plorefice/chip8-rs/chip8-pcb/models/2_42inch_oled_module-sku25742_asm.stp

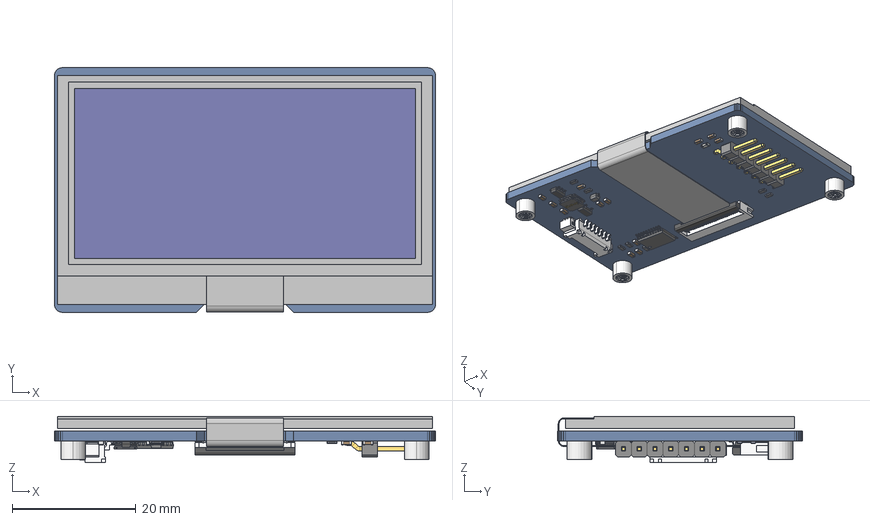
[picture p1: CAD file, 2024-06-08]
chip8-pcb/models/2_42inch_oled_module-sku25742_asm.stp
61.5 x 39.5 x 7.50 mm
BOARD
CAPC1608_0603_ x 12
USER_LIBRARY-1N4148WS
RESC1608_0603_ x 7
USER_LIBRARY-INDLQS_4012_-11547
USER_LIBRARY-INDLQS_4012_-22184 x 2
USER_LIBRARY-INDLQS_4012_-22696
HEADER-FPC-ZIF-SMD-HORIZO-23832
HEADER-FPC-ZIF-SMD-HORIZO-85751
EXTRUDED-87228
EXTRUDED-87600 x 2
SW3DPS-SOT-23-5-DEFAULT x 2
USER_LIBRARY-TSSOP-20-2__-93530
USER_LIBRARY-TSSOP-20-2__-94481
USER_LIBRARY-TSSOP-20-2__-946_1 x 10
USER_LIBRARY-TSSOP-20-2__-946_2 x 10
HDR2_54_S-W-1P-96724 x 7
LOGO0_25_10 x 7
LOGO0_25_20 x 7
LOGO0_25_30 x 7
LOGO0_25_40 x 7
LOGO0_25_50 x 7
LOGO0_25_60 x 7
LOGO0_25_70 x 7
LOGO0_25_80 x 7
LOGO0_25_90 x 7
LOGO0_25_100 x 7
LOGO0_25_110 x 7
LOGO0_25_120 x 7
LOGO0_25_130 x 7
LOGO0_25_140 x 7
2_42INCH-128X64-QLED
HP1_25MM-1X7PIN-SMT
SMTSO-M2_5-4-3ET x 4
