plorefice/chip8-rs/chip8-case/Litio_523450.FCStd

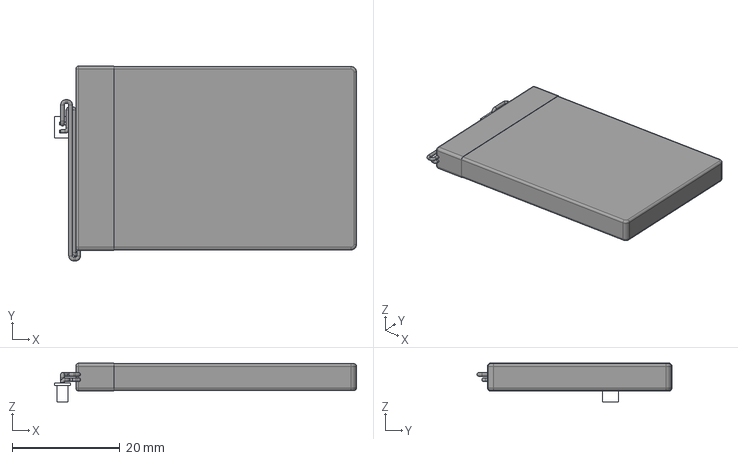
[picture p2: CAD file, 2024-06-12]
chip8-case/Litio_523450.FCStd
56.0 x 36.2 x 7.20 mm
Conector
