plorefice/chip8-rs/chip8-pcb/chip8-pcb.step

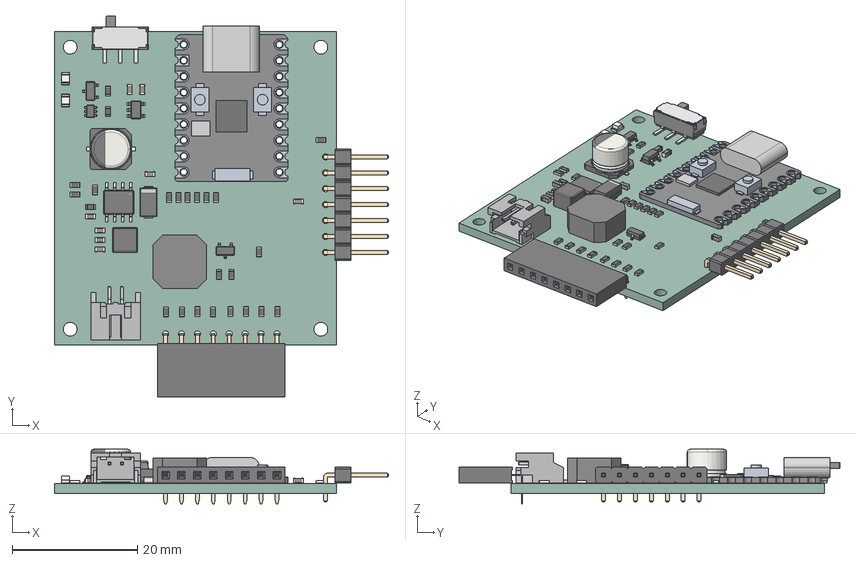
[picture p3: CAD file, 2024-06-12]
chip8-pcb/chip8-pcb.step
53.3 x 60.7 x 8.70 mm
R_0603_1608Metric x 23
SOT_23_5
C_0603_1608Metric x 8
S2B-PH-SM4-TB v1
HTSOP_8_1EP_39x49mm_P127mm_EP24x32mm
CQ assembly
LED_0805_2012Metric x 2
SOT_363_SC_70_6
PinHeader_1x07_P254mm_Horizontal
SOT_23 x 2
CP_Elec_63x54
Fuse_0603_1608Metric
JS102011SAQN
ESP32-C3 Zero (Waveshare) v6
PinSocket_1x08_P254mm_Horizontal
D_SMA
chip8-pcb_PCB
