plorefice/chip8-rs/chip8-pcb/models/JST-PH-2.step

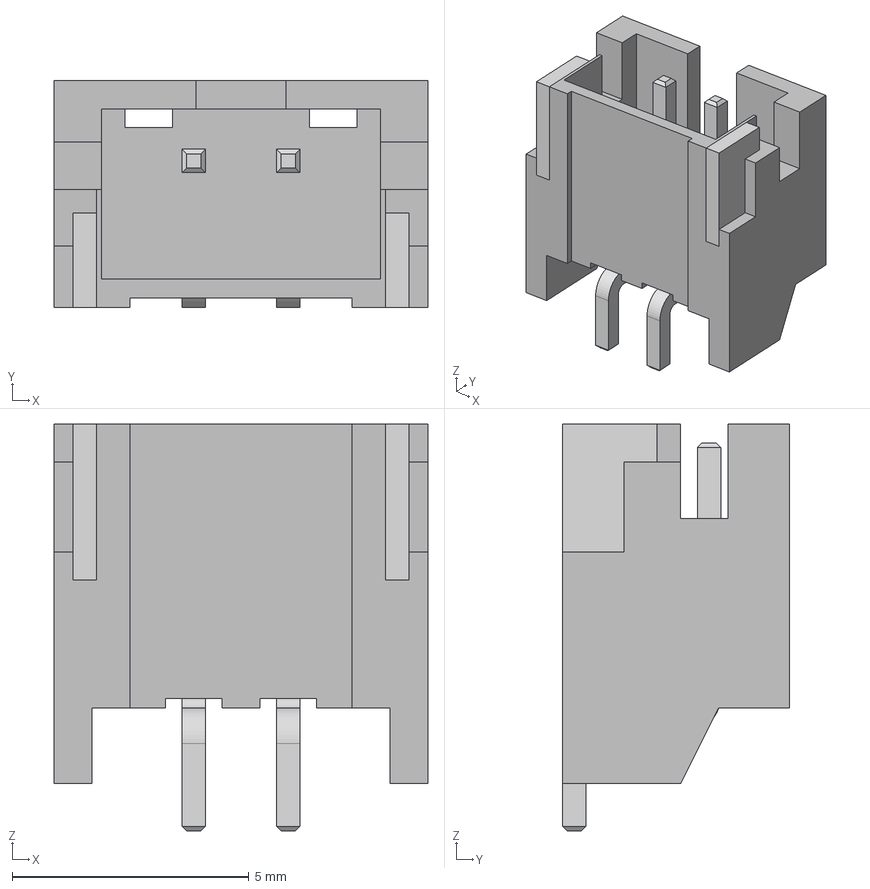
[picture p4: CAD file, 2024-06-08]
chip8-pcb/models/JST-PH-2.step
7.90 x 4.80 x 8.60 mm
