plorefice/chip8-rs/chip8-case/CHIP-8.FCStd

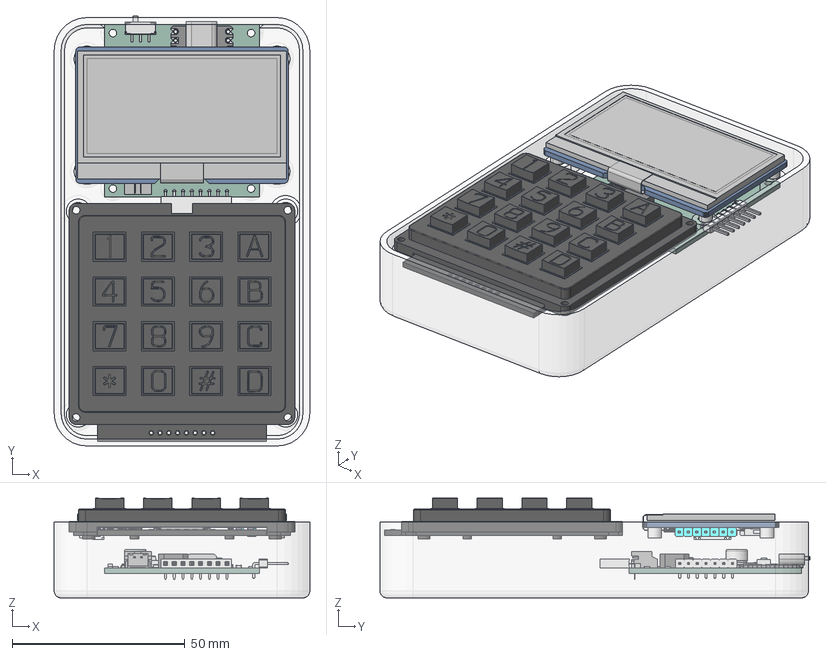
[picture p5: CAD file, 2024-06-12]
chip8-case/CHIP-8.FCStd
74.0 x 124.4 x 28.9 mm
BackCase
R_0603_1608Metric
SOT_23_5
C_0603_1608Metric
R_0603_1608Metric002
C_0603_1608Metric002
S2B-PH-SM4-TB v1
S2B-PH-SM4-TB v002
S2B-PH-SM4-TB v003
S2B-PH-SM4-TB v004
S2B-PH-SM4-TB v005
R_0603_1608Metric004
R_0603_1608Metric006
C_0603_1608Metric004
R_0603_1608Metric008
C_0603_1608Metric006
HTSOP_8_1EP_39x49mm_P127mm_EP24x32mm
CQ assembly
CQ assembly001
CQ assembly002
R_0603_1608Metric010
R_0603_1608Metric012
R_0603_1608Metric014
C_0603_1608Metric008
R_0603_1608Metric016
R_0603_1608Metric018
R_0603_1608Metric020
R_0603_1608Metric022
LED_0805_2012Metric
C_0603_1608Metric010
SOT_363_SC_70_6
PinHeader_1x07_P254mm_Horizontal
R_0603_1608Metric024
SOT_23
C_0603_1608Metric012
R_0603_1608Metric026
SOT_024
CP_Elec_63x54
R_0603_1608Metric028
LED_0805_2012Metric002
Fuse_0603_1608Metric
R_0603_1608Metric030
R_0603_1608Metric032
R_0603_1608Metric034
C_0603_1608Metric014
R_0603_1608Metric036
JS102011SAQN
R_0603_1608Metric038
ESP32-C3 Zero (Waveshare) v6
ESP32-C3 Zero (Waveshare) v007
ESP32-C3 Zero (Waveshare) v008
ESP32-C3 Zero (Waveshare) v009
ESP32-C3 Zero (Waveshare) v010
ESP32-C3 Zero (Waveshare) v011
ESP32-C3 Zero (Waveshare) v012
ESP32-C3 Zero (Waveshare) v013
ESP32-C3 Zero (Waveshare) v014
ESP32-C3 Zero (Waveshare) v015
ESP32-C3 Zero (Waveshare) v016
ESP32-C3 Zero (Waveshare) v017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
