plorefice/chip8-rs/chip8-pcb/models/Waveshare ESP32-C3 Zero.step

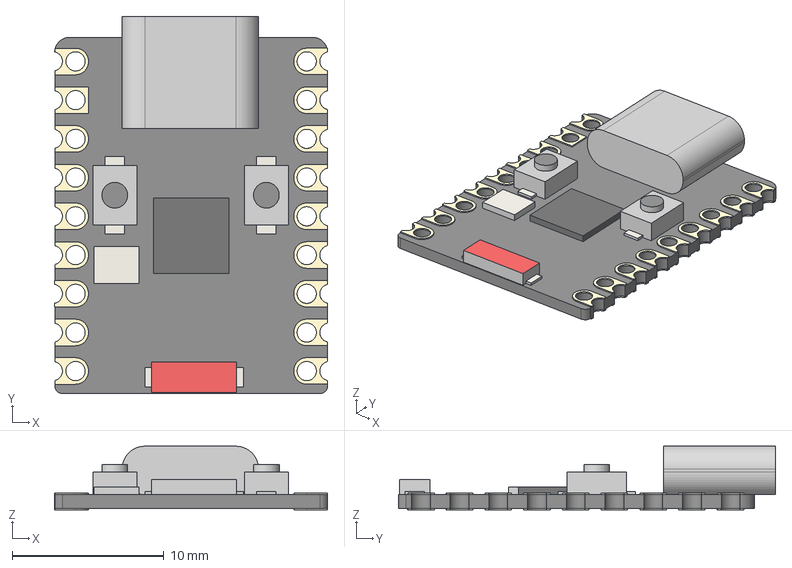
[picture p6: CAD file, 2024-06-08]
chip8-pcb/models/Waveshare ESP32-C3 Zero.step
18.0 x 24.9 x 4.20 mm
PCB
USB Type-C
SoC
BOOT
RESET
Crystal
Antenna
