plorefice/chip8-rs/chip8-pcb/models/mlt-8540.step

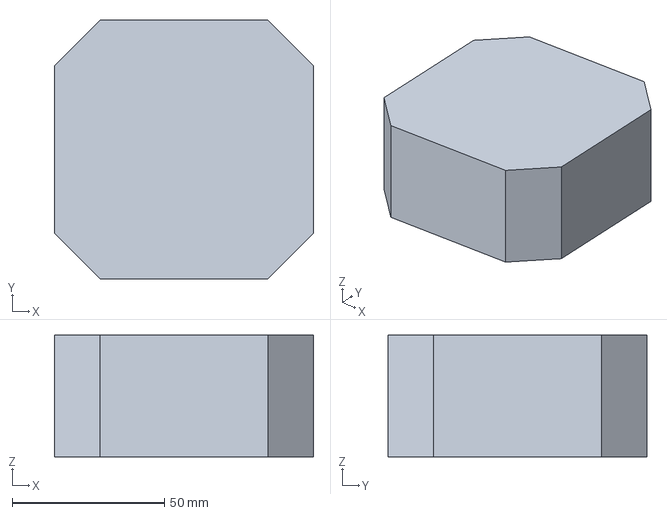
[picture p7: CAD file, 2024-06-08]
chip8-pcb/models/mlt-8540.step
85.0 x 85.0 x 40.0 mm
