plorefice/chip8-rs/chip8-pcb/models/JS102011SAQN.STEP

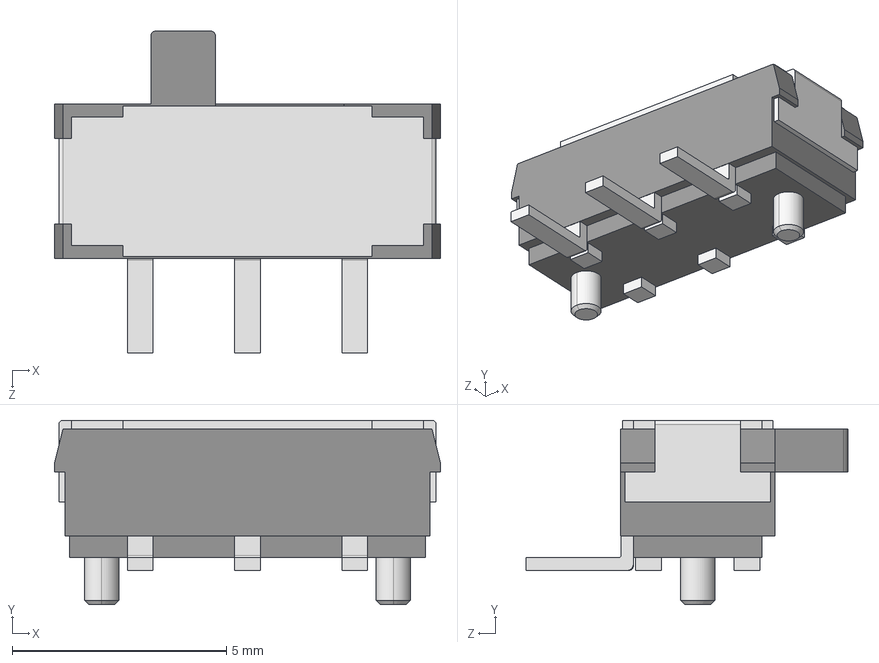
[picture p8: CAD file, 2024-06-08]
chip8-pcb/models/JS102011SAQN.STEP
9.00 x 4.30 x 7.50 mm
