plorefice/chip8-rs/(list of files, cad)

Other CAD files:
chip8-pcb/models/mlt-8540.FCStd
