plorefice/chip8-rs/chip8-pcb/chip8-pcb.kicad_pcb

## KiCad design chip8-pcb/chip8-pcb.kicad_pcb (2024-06-12)

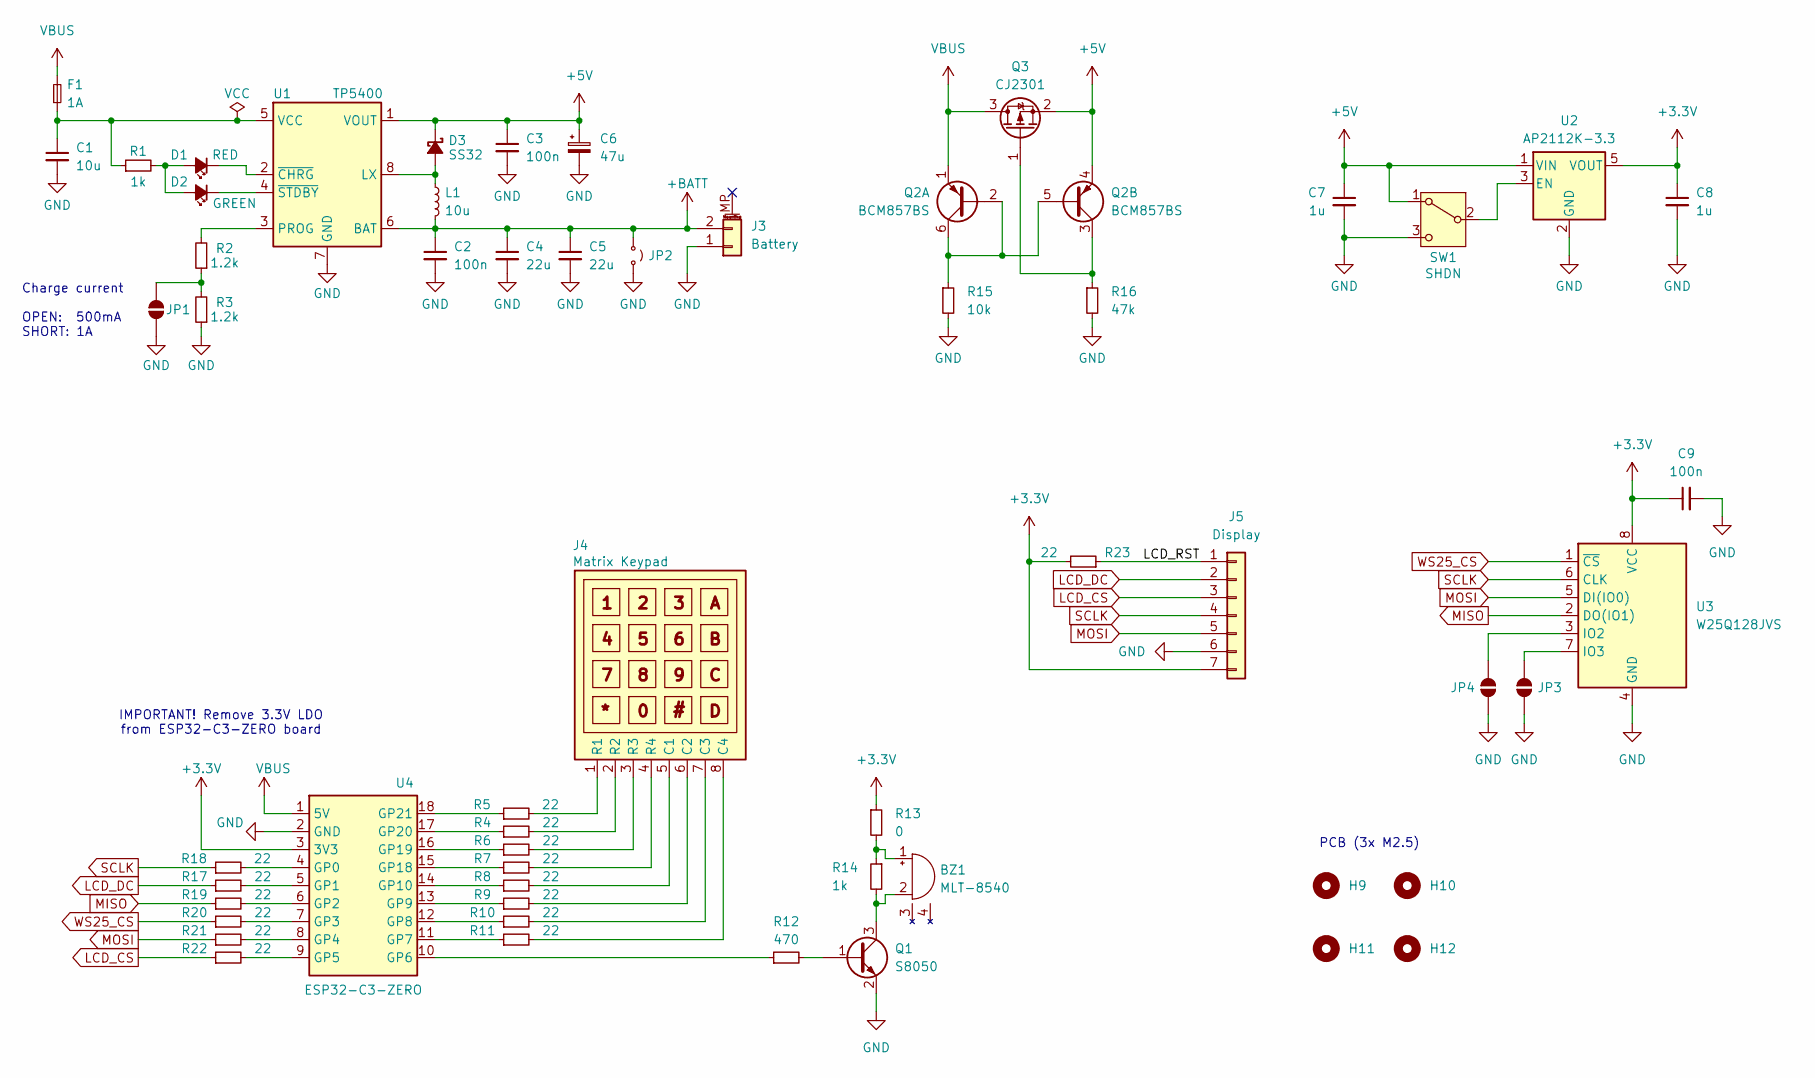
[picture p9: schematic chip8-pcb.kicad_sch, CHIP-8 Portable]

Parts:
BZ1: MLT-8540; LCSC Part Number C95300
C1: 10u; C_0603_1608Metric; LCSC Part Number C96446
C2, C3, C9: 100n; C_0603_1608Metric; LCSC Part Number C14663
C4, C5: 22u; C_0603_1608Metric; LCSC Part Number C59461
C6: 47u; CP_Elec_6.3x5.4; LCSC Part Number C72521
C7, C8: 1u; C_0603_1608Metric; LCSC Part Number C15849
D1: RED; LED_0805_2012Metric; LCSC Part Number C84256
D2: GREEN; LED_0805_2012Metric; LCSC Part Number C2297
D3: SS32; D_SMA; LCSC Part Number C34897
F1: 1A; Fuse_0603_1608Metric; LCSC Part Number C151139
H9, H10, H11, H12: MountingHole_2.2mm_M2
J3: Battery; BOOMELE_PH-2P_1x2P_P2.00mm_Horizontal; LCSC Part Number C47647
J4: Matrix Keypad; PinSocket_1x08_P2.54mm_Horizontal
J5: Display; PinHeader_1x07_P2.54mm_Horizontal
JP1, JP2, JP3, JP4: SolderJumper-2_P1.3mm_Open_RoundedPad1.0x1.5mm
L1: 10u; L_Sunlord_SWPA4030S; LCSC Part Number C5363814
Q1: S8050; SOT-23; LCSC Part Number C2146
Q2: BCM857BS; SOT-363_SC-70-6; LCSC Part Number C105896
Q3: CJ2301; SOT-23; LCSC Part Number C8547
R1, R14: 1k; R_0603_1608Metric; LCSC Part Number C21190
R2, R3: 1.2k; R_0603_1608Metric; LCSC Part Number C22765
R4, R5, R6, R7, R8, R9, R10, R11, R17, R18, R19, R20, R21, R22, R23: 22; R_0603_1608Metric; LCSC Part Number C23345
R12: 470; R_0603_1608Metric; LCSC Part Number C23179
R13: 0; R_0603_1608Metric; LCSC Part Number C21189
R15: 10k; R_0603_1608Metric; LCSC Part Number C25804
R16: 47k; R_0603_1608Metric; LCSC Part Number C25819
SW1: SHDN; SW_SPDT_CK_JS102011SAQN; LCSC Part Number C221660
U1: TP5400; HTSOP-8-1EP_3.9x4.9mm_P1.27mm_EP2.4x3.2mm_ThermalVias; LCSC Part Number C2891434
U2: AP2112K-3.3; SOT-23-5; LCSC Part Number C51118
U3: W25Q128JVS; SOIC-8_5.23x5.23mm_P1.27mm; LCSC Part Number C97521
U4: ESP32-C3-ZERO; WaveShare_ESP32-C3-ZERO

Connections:
+3.3V: C8.1, C9.1, J5.7, R13.1, R23.2, U2.5 (VOUT), U3.8 (VCC), U4.3 (3V3)
+5V: C3.1, C6.1, C7.1, D3.1 (K), Q2.4 (E2), Q3.2 (S), SW1.1 (A), U1.1 (VOUT), U2.1 (VIN)
+BATT: C2.1, C4.1, C5.1, J3.2, JP2.1 (A), L1.2, U1.6 (BAT)
/LCD_RST: J5.1, R23.1
GND: C1.2, C2.2, C3.2, C4.2, C5.2, C6.2, C7.2, C8.2, C9.2, J3.1, J5.6, JP1.1 (A), JP2.2 (B), JP3.1 (A), JP4.1 (A), Q1.2 (E), R3.1, R15.2, R16.2, SW1.3 (C), U1.7 (GND), U1.9 (GND), U2.2 (GND), U3.4 (GND), U4.2 (GND)
LCD_CS: J5.3, R22.1
LCD_DC: J5.2, R17.1
MISO: R19.1, U3.2 (DO(IO1))
MOSI: J5.5, R21.1, U3.5 (DI(IO0))
unnamed: BZ1.1 (+), R13.2, R14.1
unnamed: BZ1.2 (-), Q1.3 (C), R14.2
unnamed: D1.2 (A), D2.2 (A), R1.2
unnamed: D1.1 (K), U1.2 (~CHRG)
unnamed: D2.1 (K), U1.4 (~STDBY)
unnamed: D3.2 (A), L1.1, U1.8 (LX)
unnamed: J4.6 (C2), R9.2
unnamed: J4.7 (C3), R10.2
unnamed: J4.8 (C4), R11.2
unnamed: J4.1 (R1), R5.2
unnamed: J4.2 (R2), R4.2
unnamed: J4.3 (R3), R6.2
unnamed: J4.4 (R4), R7.2
unnamed: J4.5 (C1), R8.2
unnamed: JP1.2 (B), R2.1, R3.2
unnamed: JP3.2 (B), U3.7 (IO3)
unnamed: JP4.2 (B), U3.3 (IO2)
unnamed: Q1.1 (B), R12.2
unnamed: Q2.2 (B1), Q2.5 (B2), Q2.6 (C1), R15.1
unnamed: Q2.3 (C2), Q3.1 (G), R16.1
unnamed: SW1.2 (B), U2.3 (EN)
unnamed: R2.2, U1.3 (PROG)
unnamed: C1.1, F1.1, R1.1, U1.5 (VCC)
unnamed: R18.2, U4.4 (GP0)
unnamed: R17.2, U4.5 (GP1)
unnamed: R19.2, U4.6 (GP2)
unnamed: R20.2, U4.7 (GP3)
unnamed: R21.2, U4.8 (GP4)
unnamed: R22.2, U4.9 (GP5)
unnamed: R12.1, U4.10 (GP6)
unnamed: R11.1, U4.11 (GP7)
unnamed: R10.1, U4.12 (GP8)
unnamed: R9.1, U4.13 (GP9)
unnamed: R8.1, U4.14 (GP10)
unnamed: R7.1, U4.15 (GP18)
unnamed: R6.1, U4.16 (GP19)
unnamed: R4.1, U4.17 (GP20)
unnamed: R5.1, U4.18 (GP21)
SCLK: J5.4, R18.1, U3.6 (CLK)
VBUS: F1.2, Q2.1 (E1), Q3.3 (D), U4.1 (5V)
WS25_CS: R20.1, U3.1 (~CS)

Notes on the sheet:
PCB (3x M2.5)
IMPORTANT! Remove 3.3V LDO from ESP32-C3-ZERO board
Charge current OPEN: 500mA SHORT: 1A

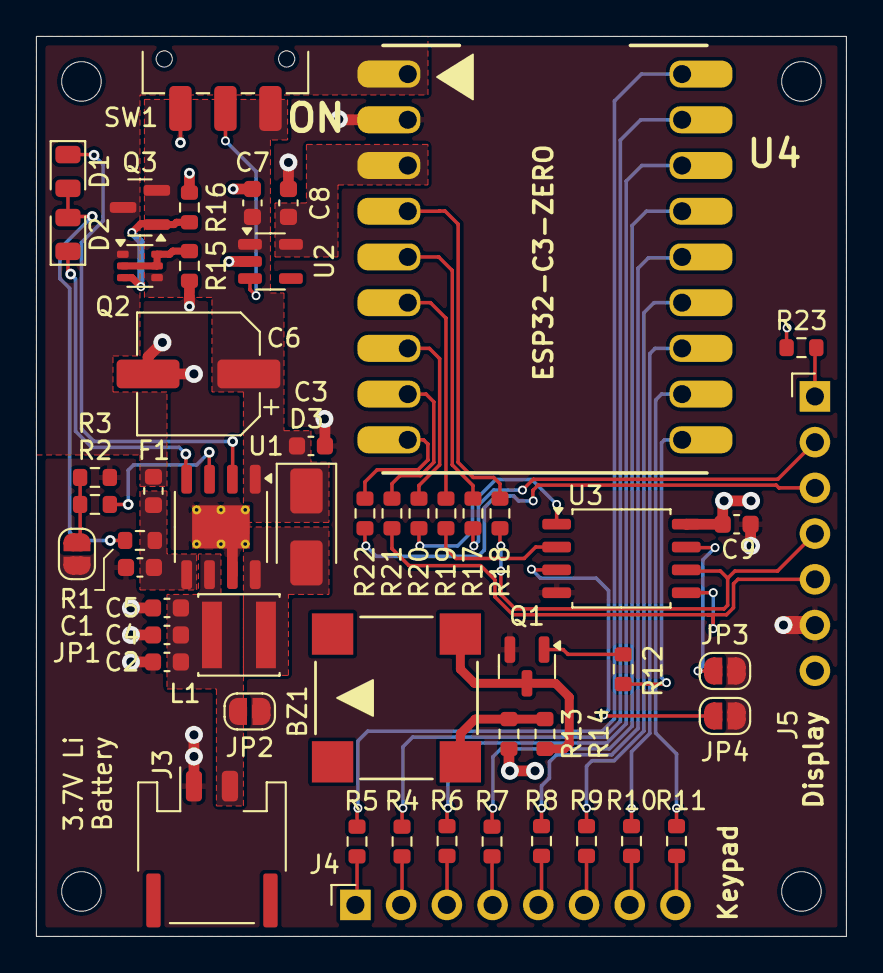
[picture p10: board chip8-pcb.kicad_pcb from above]

Board: 4 copper layers, 45.0 x 50.0 mm, 57 parts (0 on the bottom side), 50 nets.
