plorefice/chip8-rs/(commit log)

2019-01-18 Switch to cargo workspaces
2024-06-03 chip8-esp32: project skeleton
2024-06-03 chip8: switch to no_std
2024-06-03 chip8-esp32: cpu loop stub
2024-06-04 chip8-esp32: graphics
2024-06-04 chip8-esp32: 128x64 screen
2024-06-04 chip8-esp32: precise timing
2024-06-04 pcb: project stub
    [chip8-pcb.kicad_pcb, chip8-pcb.kicad_sch]
2024-06-08 chip8-pcb: final v1 version
    [2_42inch_oled_module-sku25742_asm.stp, JS102011SAQN.STEP, JST-PH-2.step, Waveshare ESP32-C3 Zero.step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]
2024-06-11 chip8-pcb: final v2 version
    [chip8-pcb-B_Cu.gbl, chip8-pcb-B_Mask.gbs, chip8-pcb-B_Paste.gbp, chip8-pcb-B_Silkscreen.gbo, chip8-pcb-Edge_Cuts.gm1, chip8-pcb-F_Cu.gtl, chip8-pcb-F_Mask.gts, chip8-pcb-F_Paste.gtp]
2024-06-12 case: initial version
    [CHIP-8.FCStd]
2024-06-12 pcb: move battery and display connectors
    [chip8-pcb.kicad_pcb, chip8-pcb.kicad_sch, chip8-pcb.step]
2024-06-12 case: import pcb step model
    [CHIP-8.FCStd]
2024-06-12 case: import keypad and oled step models
    [CHIP-8.FCStd]
2024-06-12 case: import lipo battery model
    [Litio_523450.FCStd]
